jackm2983/mmwLab/README.md

# Advanced Microwave Lab
EE541  
Dr. Nayeri  
Spring 2026  

## Team Members
Jack Marshall  
Mark Negus  
Antoni Gonzalez  
Leo Joseph Alvelais  
Paul Obrecht  
William Robert Pfaff
