jackm2983/mmwLab/hpbw.png

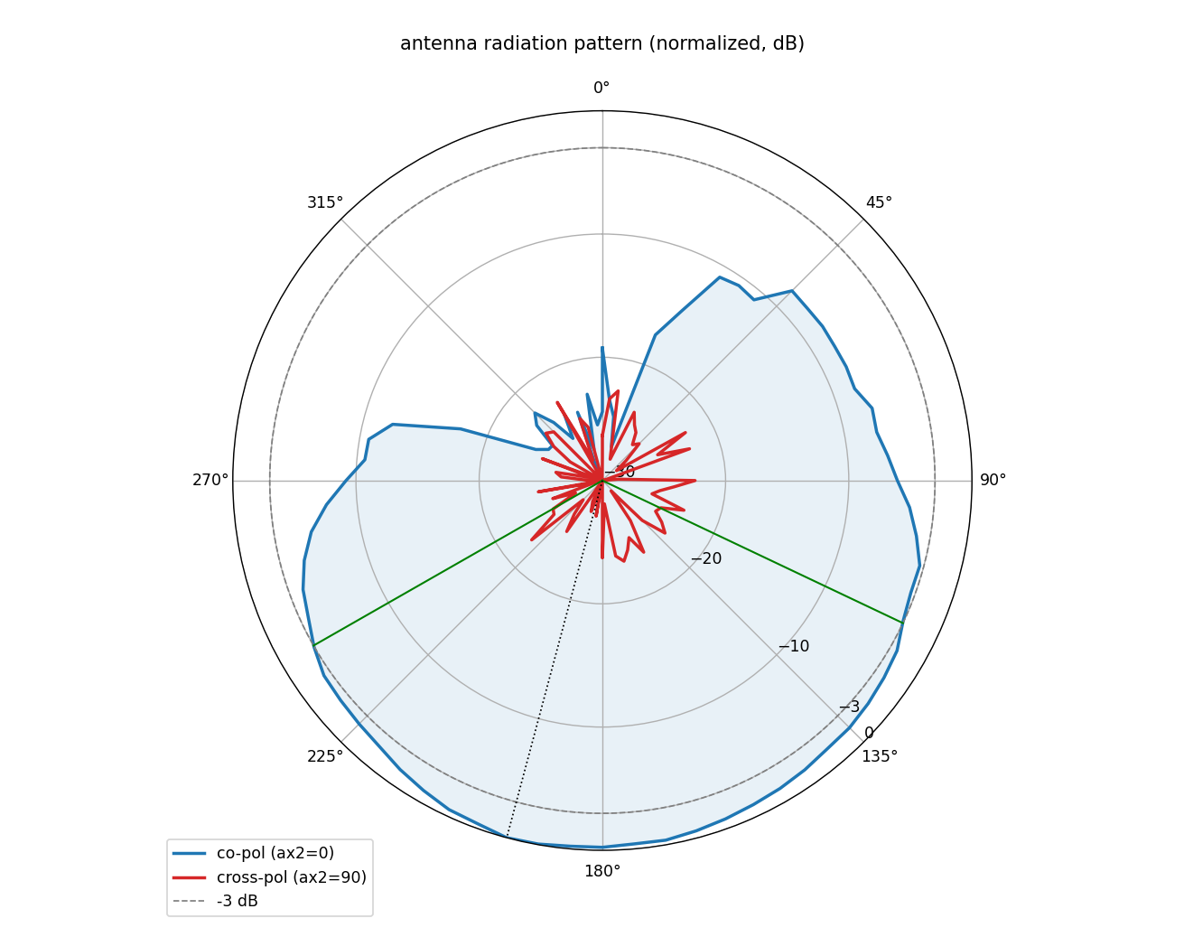
hpbw.png
