jackm2983/mmwLab/polar_sweep_001_ax2_1.png

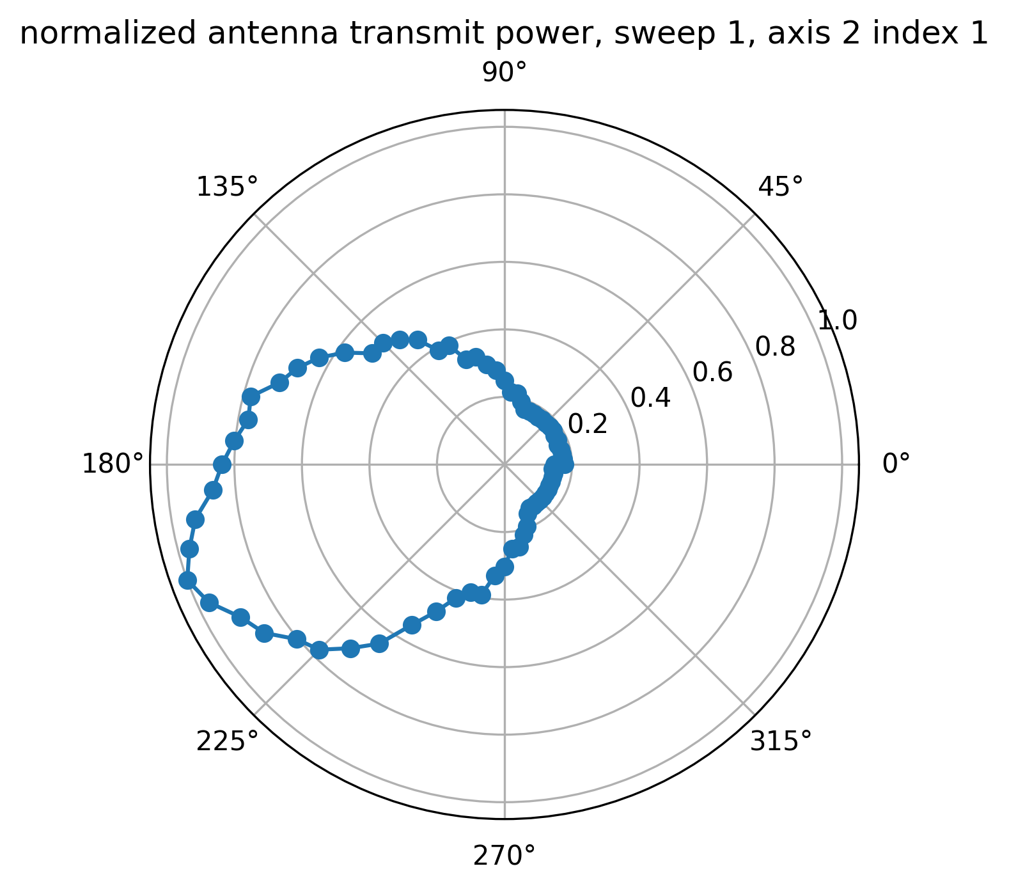
polar_sweep_001_ax2_1.png
