jackm2983/mmwLab/polarization_waterfall.png

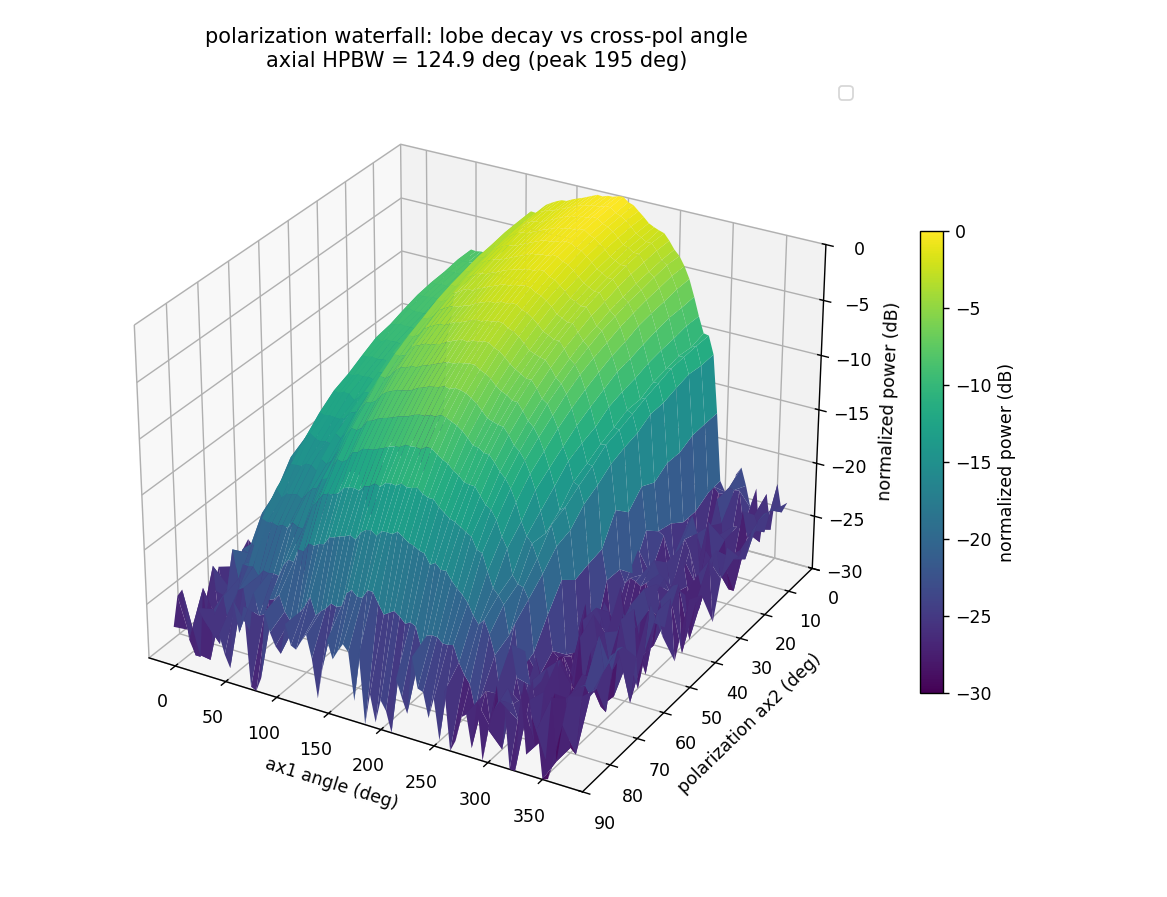
polarization_waterfall.png
