jackm2983/mmwLab/3Dmodels/rev3/new/tilt-pulley-mount2.STEP

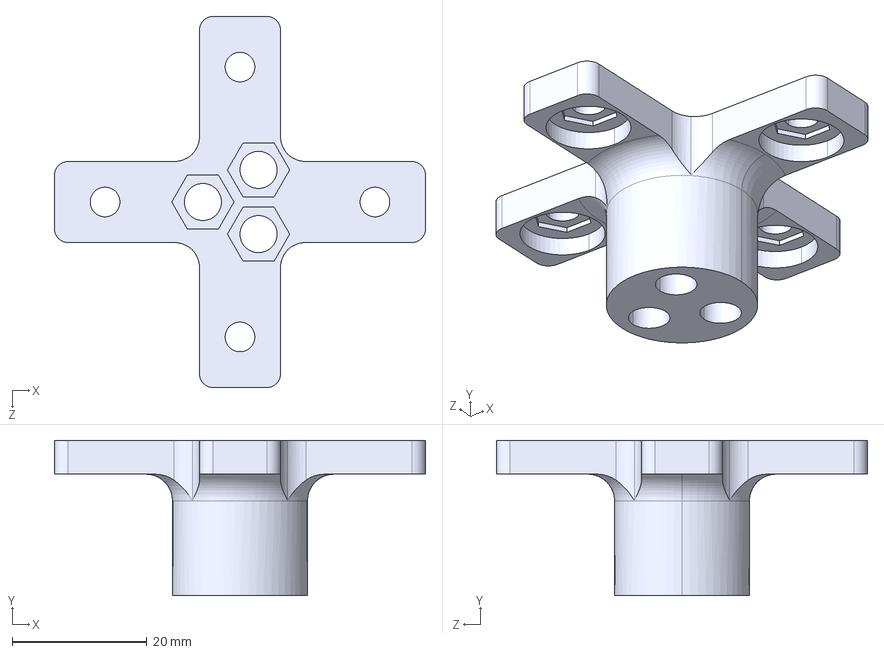
[picture p73: CAD file, 2026-05-03]
3Dmodels/rev3/new/tilt-pulley-mount2.STEP
55.0 x 23.0 x 55.0 mm
