jackm2983/mmwLab/3Dmodels/rev3/new2/tilt-pulley-mount3.step

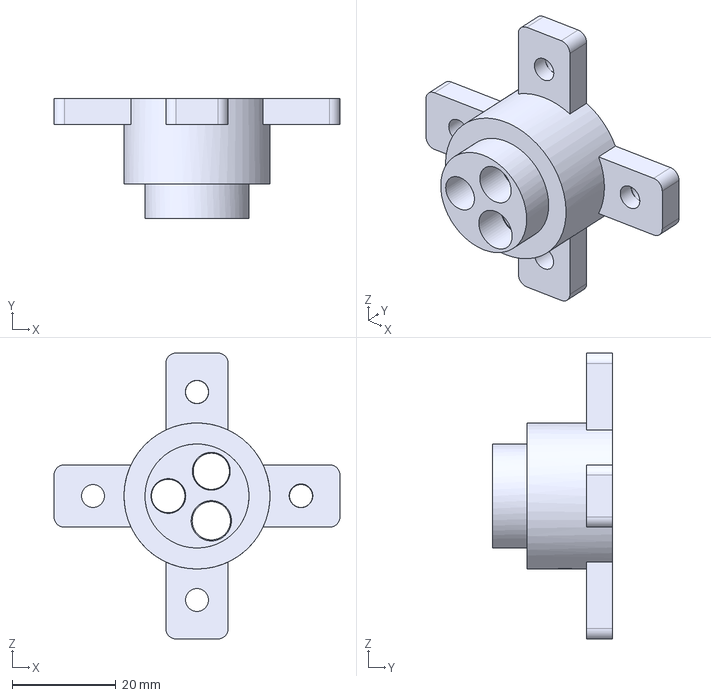
[picture p74: CAD file, 2026-05-07]
3Dmodels/rev3/new2/tilt-pulley-mount3.step
55.0 x 23.0 x 55.0 mm
