jackm2983/mmwLab/3Dmodels/rev3/tilt-arm-brace.step

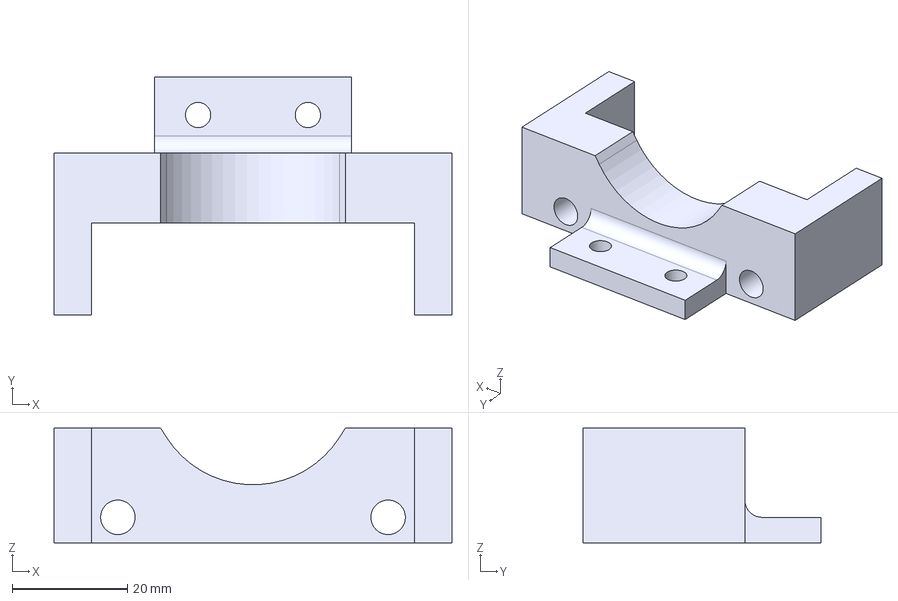
[picture p75: CAD file, 2026-05-03]
3Dmodels/rev3/tilt-arm-brace.step
69.2 x 41.4 x 20.0 mm
