jackm2983/mmwLab/3Dmodels/rev3/new/motor_driver_case.step

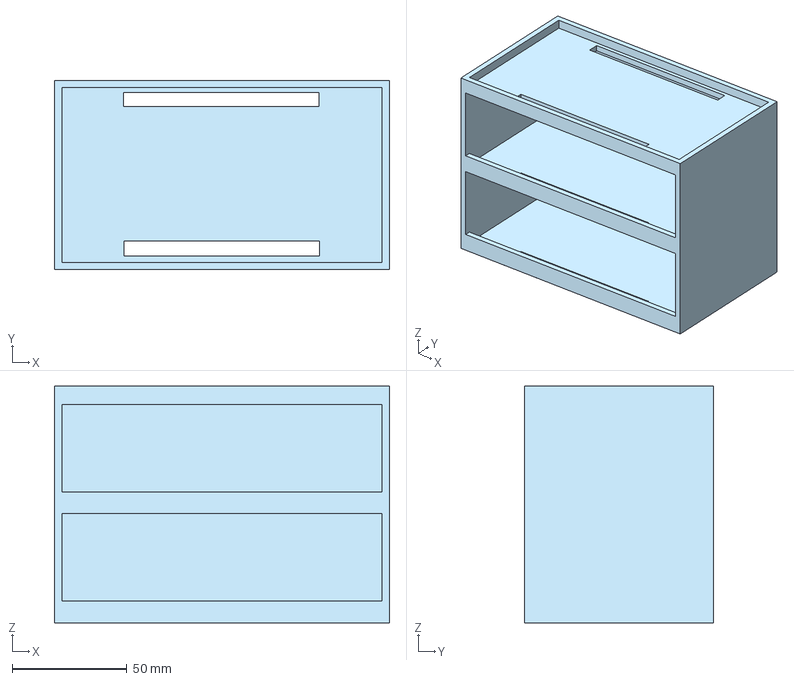
[picture p76: CAD file, 2026-05-03]
3Dmodels/rev3/new/motor_driver_case.step
146.1 x 82.5 x 103.2 mm
