jackm2983/mmwLab/3Dmodels/rev3/pan-pulley-114t-gt2-pulley-9mm-wide.step

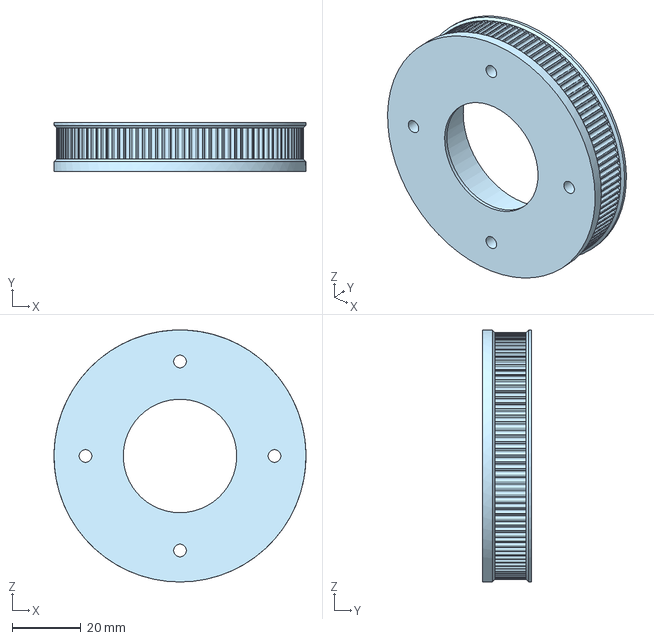
[picture p77: CAD file, 2026-05-03]
3Dmodels/rev3/pan-pulley-114t-gt2-pulley-9mm-wide.step
73.3 x 14.2 x 73.3 mm
