jackm2983/mmwLab/3Dmodels/rev3/new/base2.STEP

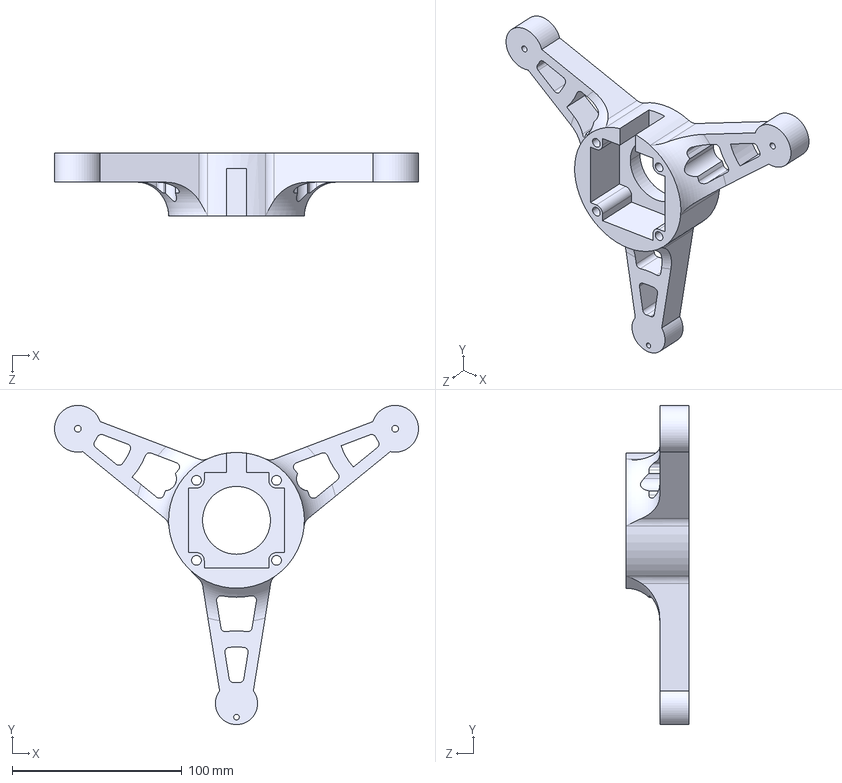
[picture p78: CAD file, 2026-05-03]
3Dmodels/rev3/new/base2.STEP
214.5 x 188.1 x 37.3 mm
