jackm2983/mmwLab/3Dmodels/rev3/tilt-pulley-98t-gt2-pulley-9mm-wide.step

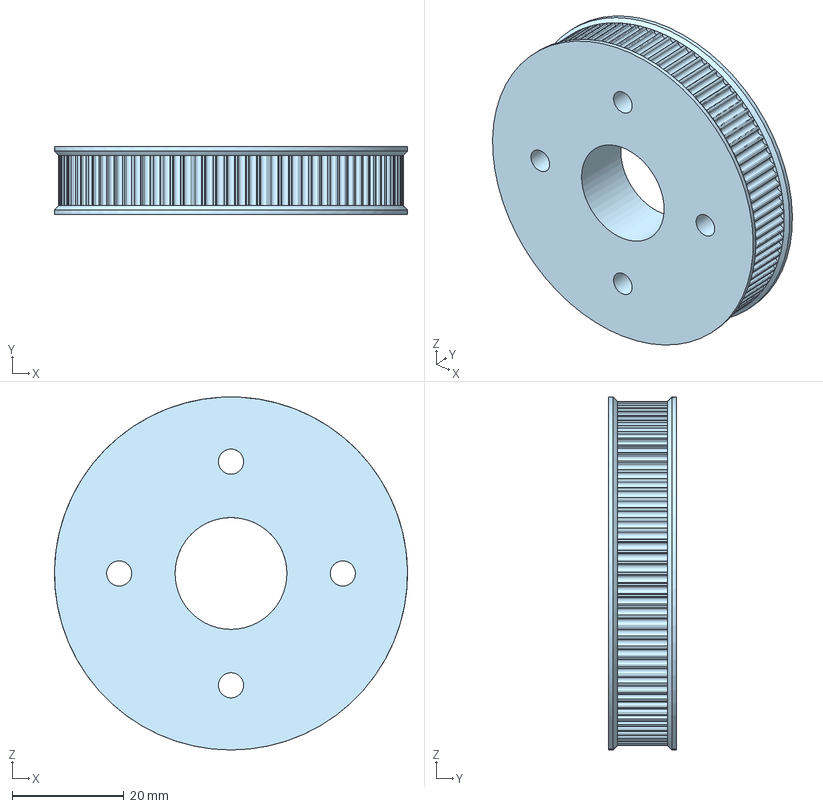
[picture p79: CAD file, 2026-05-03]
3Dmodels/rev3/tilt-pulley-98t-gt2-pulley-9mm-wide.step
63.1 x 12.2 x 63.1 mm
