jackm2983/mmwLab/3Dmodels/rev3/new/tilt-arm2.STEP

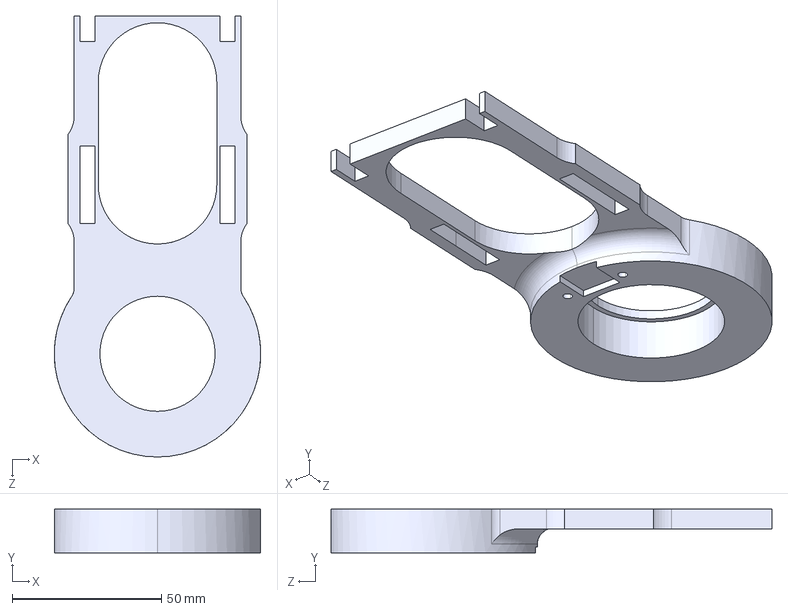
[picture p80: CAD file, 2026-05-03]
3Dmodels/rev3/new/tilt-arm2.STEP
69.2 x 14.6 x 147.9 mm
