jackm2983/mmwLab/3Dmodels/rev3/pan-endstop-mount.step

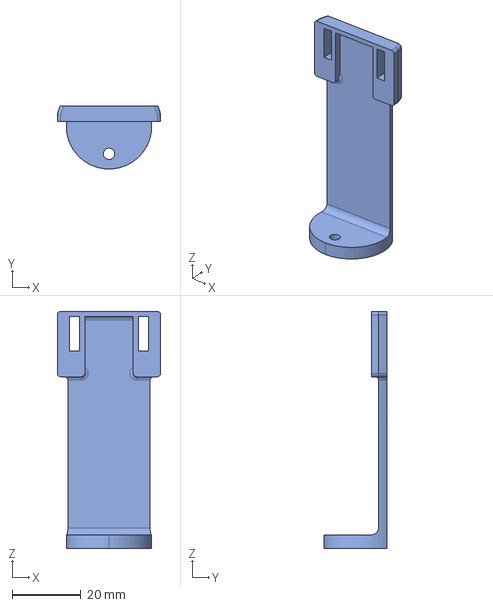
[picture p81: CAD file, 2026-05-03]
3Dmodels/rev3/pan-endstop-mount.step
30.1 x 18.4 x 69.0 mm
