jackm2983/mmwLab/3Dmodels/rev3/tilt-pulley-mount.step

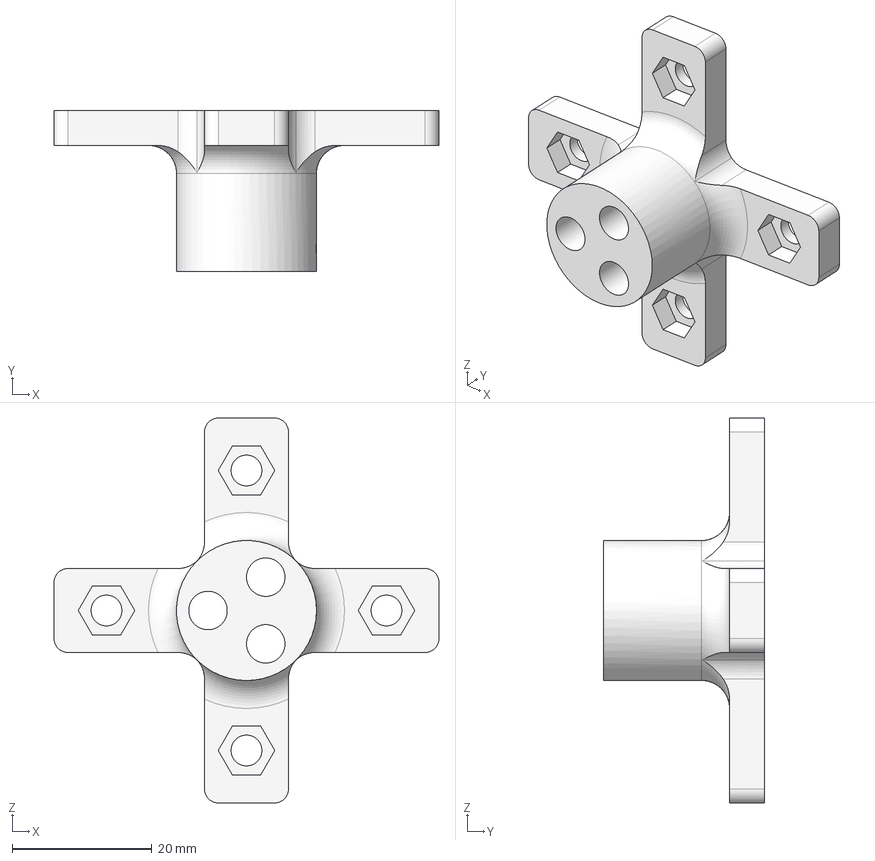
[picture p82: CAD file, 2026-05-03]
3Dmodels/rev3/tilt-pulley-mount.step
55.0 x 23.0 x 55.0 mm
