jackm2983/mmwLab/3Dmodels/rev3/tilt-endstop-triggers.step

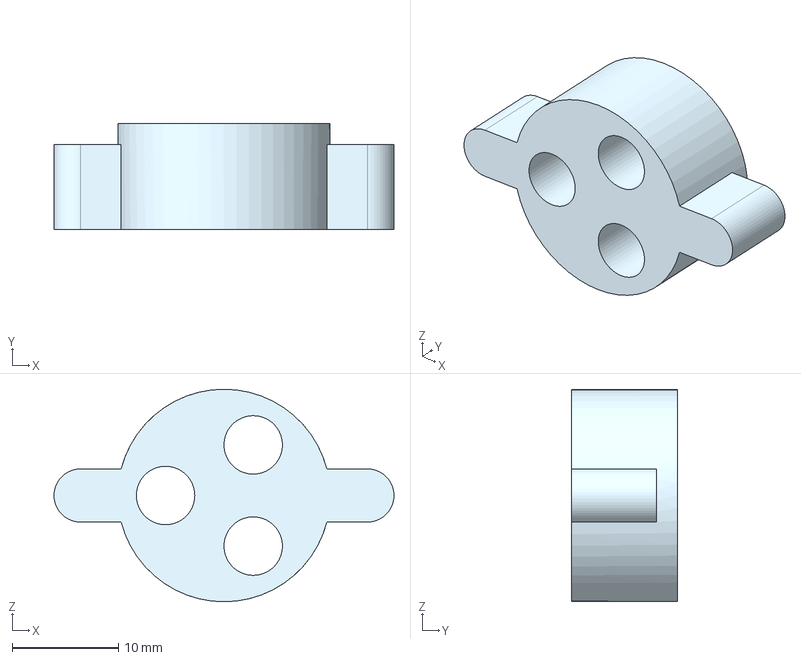
[picture p83: CAD file, 2026-05-03]
3Dmodels/rev3/tilt-endstop-triggers.step
32.0 x 10.0 x 20.0 mm
