jackm2983/mmwLab/3Dmodels/rev3/tilt-arm.step

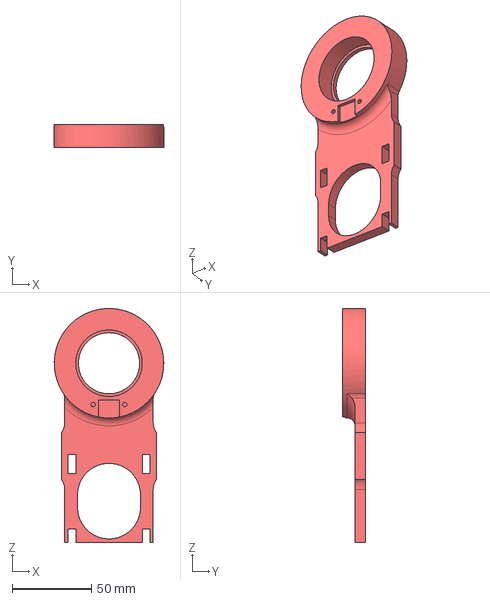
[picture p84: CAD file, 2026-05-03]
3Dmodels/rev3/tilt-arm.step
69.2 x 14.6 x 147.8 mm
