jackm2983/mmwLab/3Dmodels/rev3/pan-bearing-holder.step

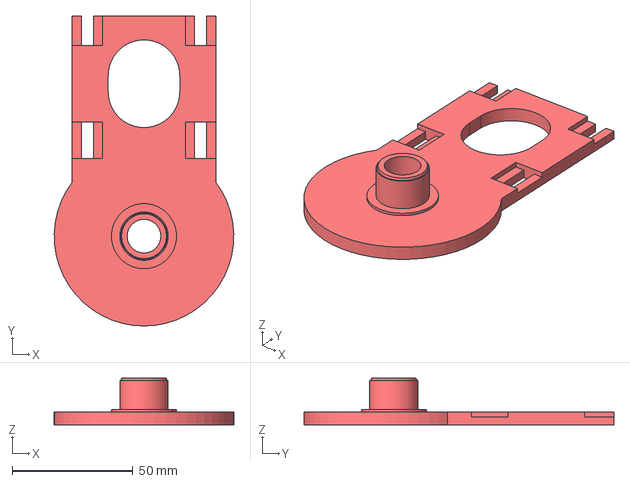
[picture p85: CAD file, 2026-05-03]
3Dmodels/rev3/pan-bearing-holder.step
74.5 x 128.6 x 19.3 mm
