jackm2983/mmwLab/3Dmodels/rev3/brace.step

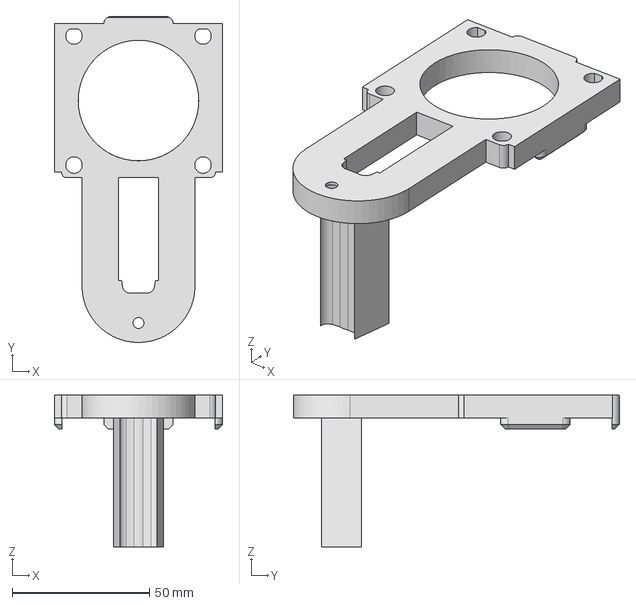
[picture p86: CAD file, 2026-05-03]
3Dmodels/rev3/brace.step
61.2 x 118.7 x 55.3 mm
