jackm2983/mmwLab/3Dmodels/rev3/tilt-motor-brace.step

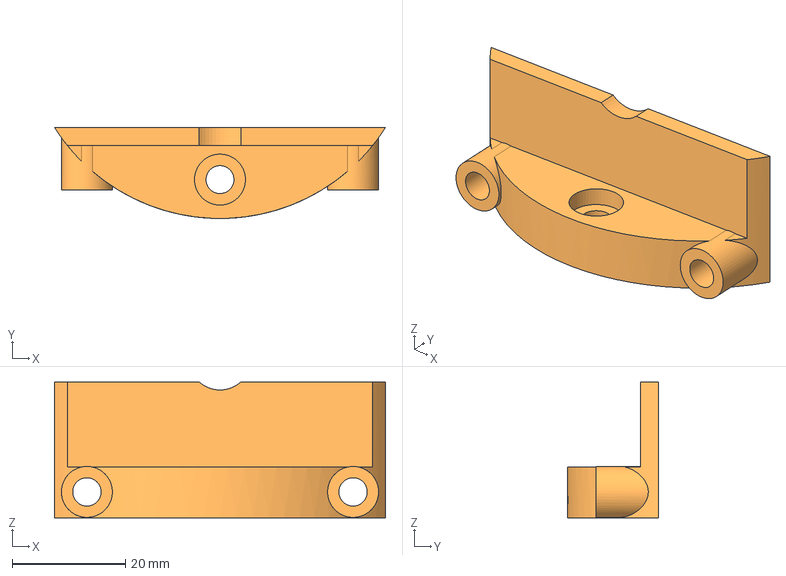
[picture p87: CAD file, 2026-05-03]
3Dmodels/rev3/tilt-motor-brace.step
58.4 x 16.1 x 24.0 mm
