jackm2983/mmwLab/3Dmodels/rev3/base.step

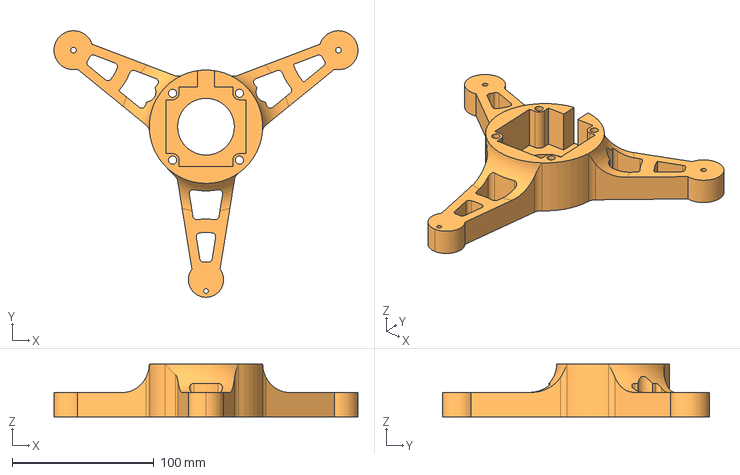
[picture p88: CAD file, 2026-05-03]
3Dmodels/rev3/base.step
214.5 x 188.1 x 37.3 mm
