jackm2983/mmwLab/3Dmodels/rev3/sony-rx100-iii-mount.step

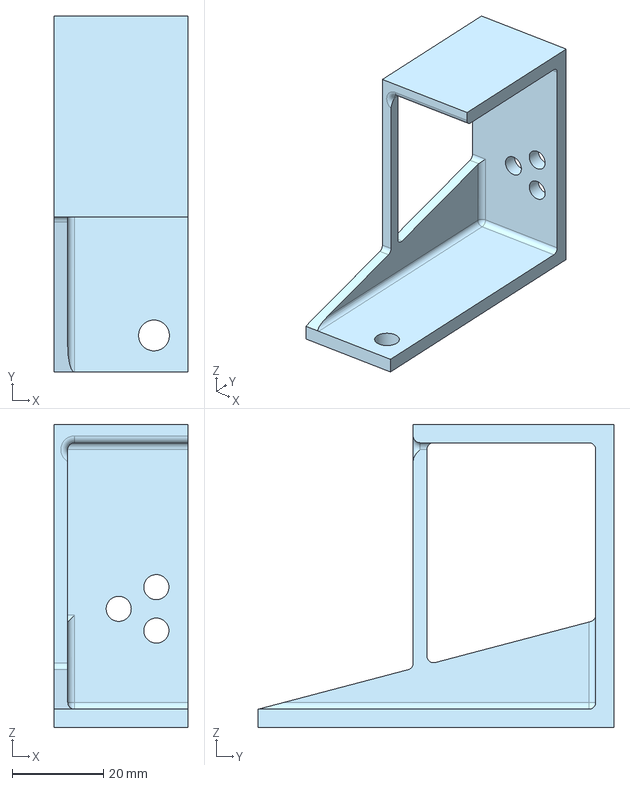
[picture p89: CAD file, 2026-05-03]
3Dmodels/rev3/sony-rx100-iii-mount.step
29.4 x 78.0 x 66.4 mm
