jackm2983/mmwLab/3Dmodels/rev3/pan-arm.step

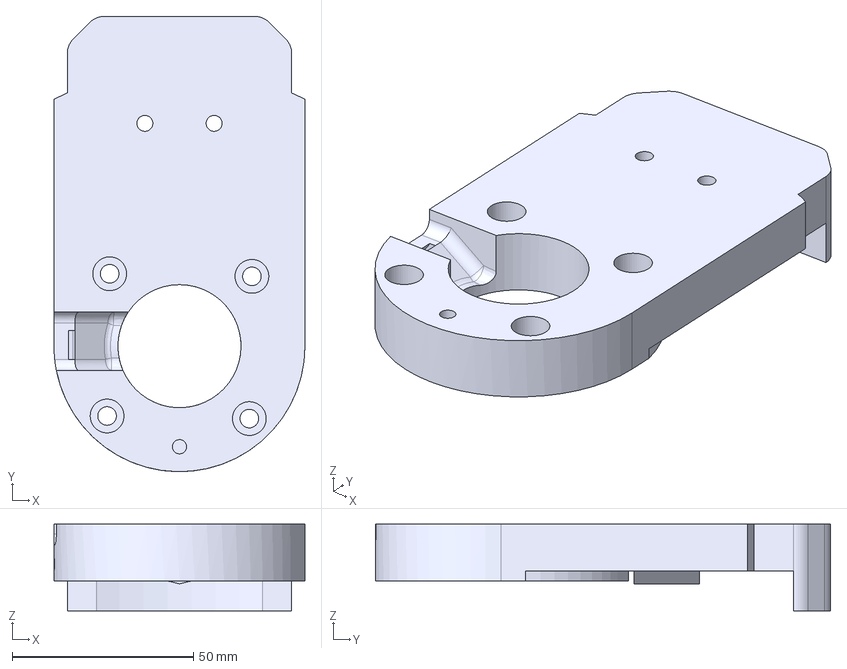
[picture p90: CAD file, 2026-05-03]
3Dmodels/rev3/pan-arm.step
69.2 x 125.6 x 24.0 mm
