jackm2983/mmwLab/(list of files, cad)

Other CAD files:
3Dmodels/rev3/brace.step.SLDPRT
3Dmodels/rev3/base.SLDPRT
3Dmodels/rev3/sony-rx100-iii-mount.SLDPRT
3Dmodels/rev3/tilt-arm.SLDPRT
3Dmodels/rev3/tilt-endstop-triggers.SLDPRT
3Dmodels/rev3/tilt-motor-brace.SLDPRT
3Dmodels/rev3/tilt-pulley-mount.SLDPRT
