jackm2983/mmwLab/STM32/mmwLab_stm32/polar_plots/uart_capture_plot.py

import csv
import math
import os
import queue
import threading
import time
from datetime import datetime

import matplotlib.pyplot as plt
import serial


PORT = "COM3"
BAUD = 9600

RAW_CSV_PATH = "capture_log_raw.csv"
NORMALIZED_CSV_PATH = "capture_log_normalized.csv"

# scripts are inside polar_plots, so save pngs in the current folder
PNG_DIR = "."

AX1_STEPS_PER_REV = 72


def cleanup_previous_capture():
    for path in (RAW_CSV_PATH, NORMALIZED_CSV_PATH):
        if os.path.exists(path):
            os.remove(path)
            print(f"deleted {path}")

    for filename in os.listdir(PNG_DIR):
        if filename.lower().endswith(".png"):
            png_path = os.path.join(PNG_DIR, filename)
            os.remove(png_path)
            print(f"deleted {png_path}")


def serial_reader(ser, line_queue, stop_event):
    while not stop_event.is_set():
        try:
            raw = ser.readline()

            if not raw:
                continue

            line = raw.decode("utf-8", errors="replace").strip()

            if line:
                print(line)
                line_queue.put(line)

        except serial.SerialException as e:
            print(f"serial error: {e}")
            stop_event.set()
            break


def serial_writer(ser, stop_event):
    import msvcrt

    while not stop_event.is_set():
        if msvcrt.kbhit():
            ch = msvcrt.getch()

            if ch in (b"\x00", b"\xe0"):
                msvcrt.getch()
                continue

            if ch == b"\x03":
                stop_event.set()
                break

            ser.write(ch)

        time.sleep(0.005)


def parse_cap_step_header(line):
    """Parse cap_step header line with new raw sampling format"""
    parts = line.split(",")

    if len(parts) != 6 or parts[0] != "cap_step":
        return None

    try:
        ax1_idx = int(parts[1])
        ax2_idx = int(parts[2])
        ax1_pos = int(parts[3])
        ax2_pos = int(parts[4])
        sample_count = int(parts[5])
    except ValueError:
        return None

    return {
        "ax1_idx": ax1_idx,
        "ax2_idx": ax2_idx,
        "ax1_pos": ax1_pos,
        "ax2_pos": ax2_pos,
        "sample_count": sample_count,
    }


def parse_cap_sample(line):
    """Parse individual cap_sample line with filtered I/Q values"""
    parts = line.split(",")

    if len(parts) != 3 or parts[0] != "cap_sample":
        return None

    try:
        i_filt = float(parts[1])
        q_filt = float(parts[2])
    except ValueError:
        return None

    # Compute magnitude (power) for this sample
    magnitude = math.sqrt(i_filt * i_filt + q_filt * q_filt)

    return {
        "i": i_filt,
        "q": q_filt,
        "magnitude": magnitude,
    }


def compute_step_power(samples):
    """
    Compute power for a measurement step from a list of samples.
    Uses the peak-to-peak amplitude of the signal over the measurement window.
    """
    if not samples:
        return 0.0

    # Find min and max magnitude across all samples
    magnitudes = [s["magnitude"] for s in samples]
    min_mag = min(magnitudes)
    max_mag = max(magnitudes)

    # Power is derived from peak-to-peak amplitude
    # For a sinusoid with amplitude A, peak-to-peak is 2A, so A = (max-min)/2
    # Power ~ A^2 ~ ((max-min)/2)^2
    peak_to_peak = max_mag - min_mag

    # Return RMS-like estimate: (peak_to_peak / 2)^2 / 2
    # Or simpler: just use max magnitude as power estimate
    return max_mag


def parse_cap_line_old(line):
    """Parse old single-value format (kept for compatibility if needed)"""
    parts = line.split(",")

    if len(parts) != 7 or parts[0] != "cap":
        return None

    try:
        ax1_idx = int(parts[1])
        ax2_idx = int(parts[2])
        ax1_pos = int(parts[3])
        ax2_pos = int(parts[4])
        i_val = int(parts[5])
        q_val = int(parts[6])
    except ValueError:
        return None

    power = math.sqrt(i_val * i_val + q_val * q_val)

    return {
        "timestamp": datetime.now().isoformat(timespec="milliseconds"),
        "ax1_idx": ax1_idx,
        "ax2_idx": ax2_idx,
        "ax1_pos": ax1_pos,
        "ax2_pos": ax2_pos,
        "i": i_val,
        "q": q_val,
        "power": power,
    }


def theta_from_ax1_idx(ax1_idx):
    return math.radians((ax1_idx * 360.0) / AX1_STEPS_PER_REV)


def save_sweep_png(rows, sweep_id, ax2_idx, path_dir=PNG_DIR):
    sweep_rows = [
        r for r in rows
        if r["sweep_id"] == sweep_id
    ]

    if not sweep_rows:
        return

    sweep_max_power = max(r["power"] for r in sweep_rows)

    theta = [
        theta_from_ax1_idx(r["ax1_idx"])
        for r in sweep_rows
    ]

    if sweep_max_power > 0:
        radius = [
            r["power"] / sweep_max_power
            for r in sweep_rows
        ]
    else:
        radius = [0.0 for _ in sweep_rows]

    os.makedirs(path_dir, exist_ok=True)

    png_path = os.path.join(
        path_dir,
        f"polar_sweep_{sweep_id:03d}_ax2_{ax2_idx}.png",
    )

    save_fig = plt.figure()
    save_ax = save_fig.add_subplot(111, projection="polar")

    save_ax.plot(theta, radius, marker="o")
    save_ax.set_title(
        f"normalized antenna transmit power, sweep {sweep_id}, axis 2 index {ax2_idx}"
    )
    save_ax.set_ylim(0, 1.05)
    save_ax.grid(True)

    save_fig.savefig(png_path, dpi=300, bbox_inches="tight")
    plt.close(save_fig)

    print(f"polar png written to {png_path}")


def write_normalized_csv(rows, path):
    if not rows:
        return

    sweep_max = {}

    for row in rows:
        sweep_id = row["sweep_id"]
        sweep_max[sweep_id] = max(sweep_max.get(sweep_id, 0.0), row["power"])

    normalized_rows = []

    for row in rows:
        out = row.copy()
        max_power = sweep_max[row["sweep_id"]]

        if max_power > 0:
            out["power_norm_sweep"] = out["power"] / max_power

            if out["power_norm_sweep"] > 0:
                out["power_db_norm"] = 20.0 * math.log10(out["power_norm_sweep"])
            else:
                out["power_db_norm"] = None
        else:
            out["power_norm_sweep"] = 0.0
            out["power_db_norm"] = None

        normalized_rows.append(out)

    fieldnames = [
        "timestamp",
        "sweep_id",
        "ax1_idx",
        "ax2_idx",
        "ax1_pos",
        "ax2_pos",
        "power",
        "power_norm_sweep",
        "power_db_norm",
    ]

    with open(path, "w", newline="") as f:
        writer = csv.DictWriter(f, fieldnames=fieldnames)
        writer.writeheader()
        writer.writerows(normalized_rows)


def main():
    cleanup_previous_capture()

    line_queue = queue.Queue()
    stop_event = threading.Event()

    ser = serial.Serial(PORT, BAUD, timeout=0.1)

    reader = threading.Thread(
        target=serial_reader,
        args=(ser, line_queue, stop_event),
        daemon=True,
    )

    writer = threading.Thread(
        target=serial_writer,
        args=(ser, stop_event),
        daemon=True,
    )

    reader.start()
    writer.start()

    rows = []

    sweep_id = -1
    last_ax2_idx = None
    current_sweep_id = None
    current_ax2_idx = None
    saved_sweep_ids = set()

    raw_fieldnames = [
        "timestamp",
        "sweep_id",
        "ax1_idx",
        "ax2_idx",
        "ax1_pos",
        "ax2_pos",
        "power",
        "sample_count",
    ]

    raw_csv_file = open(RAW_CSV_PATH, "w", newline="")
    raw_writer = csv.DictWriter(raw_csv_file, fieldnames=raw_fieldnames)
    raw_writer.writeheader()

    plt.ion()

    fig = plt.figure()
    ax = fig.add_subplot(111, projection="polar")

    line_plot, = ax.plot([], [], marker="o")

    ax.set_title("normalized antenna transmit power")
    ax.set_ylim(0, 1.05)
    ax.grid(True)

    # State for buffering samples during streaming
    current_step = None
    buffered_samples = []

    try:
        while not stop_event.is_set():
            updated = False

            while not line_queue.empty():
                line = line_queue.get()

                # Parse cap_step header
                step_header = parse_cap_step_header(line)
                if step_header is not None:
                    # If we have buffered samples from previous step, process them
                    if current_step is not None and buffered_samples:
                        # Compute power from buffered samples
                        power = compute_step_power(buffered_samples)

                        row = {
                            "timestamp": datetime.now().isoformat(timespec="milliseconds"),
                            "ax1_idx": current_step["ax1_idx"],
                            "ax2_idx": current_step["ax2_idx"],
                            "ax1_pos": current_step["ax1_pos"],
                            "ax2_pos": current_step["ax2_pos"],
                            "power": power,
                            "sample_count": len(buffered_samples),
                        }

                        # Check if this is a new sweep (new ax2_idx)
                        if row["ax2_idx"] != last_ax2_idx:
                            if (
                                current_sweep_id is not None
                                and current_sweep_id not in saved_sweep_ids
                            ):
                                save_sweep_png(rows, current_sweep_id, current_ax2_idx)
                                saved_sweep_ids.add(current_sweep_id)

                            sweep_id += 1
                            last_ax2_idx = row["ax2_idx"]
                            print(f"new sweep {sweep_id}, axis 2 index {row['ax2_idx']}")

                        row["sweep_id"] = sweep_id

                        rows.append(row)
                        raw_writer.writerow(row)
                        raw_csv_file.flush()

                        current_sweep_id = sweep_id
                        current_ax2_idx = row["ax2_idx"]
                        updated = True

                    # Start buffering for new step
                    current_step = step_header
                    buffered_samples = []
                    continue

                # Parse cap_sample line
                sample = parse_cap_sample(line)
                if sample is not None:
                    buffered_samples.append(sample)
                    continue

                # Handle end of capture
                if line == "cap_end":
                    # Process last buffered samples
                    if current_step is not None and buffered_samples:
                        power = compute_step_power(buffered_samples)

                        row = {
                            "timestamp": datetime.now().isoformat(timespec="milliseconds"),
                            "ax1_idx": current_step["ax1_idx"],
                            "ax2_idx": current_step["ax2_idx"],
                            "ax1_pos": current_step["ax1_pos"],
                            "ax2_pos": current_step["ax2_pos"],
                            "power": power,
                            "sample_count": len(buffered_samples),
                        }

                        if row["ax2_idx"] != last_ax2_idx:
                            if (
                                current_sweep_id is not None
                                and current_sweep_id not in saved_sweep_ids
                            ):
                                save_sweep_png(rows, current_sweep_id, current_ax2_idx)
                                saved_sweep_ids.add(current_sweep_id)

                            sweep_id += 1
                            last_ax2_idx = row["ax2_idx"]

                        row["sweep_id"] = sweep_id

                        rows.append(row)
                        raw_writer.writerow(row)
                        raw_csv_file.flush()

                        current_sweep_id = sweep_id
                        current_ax2_idx = row["ax2_idx"]
                        updated = True

                    print("Capture complete")
                    stop_event.set()
                    continue

            if updated and current_sweep_id is not None:
                plot_rows = [
                    r for r in rows
                    if r["sweep_id"] == current_sweep_id
                ]

                if plot_rows:
                    sweep_max_power = max(r["power"] for r in plot_rows)

                    theta = [
                        theta_from_ax1_idx(r["ax1_idx"])
                        for r in plot_rows
                    ]

                    if sweep_max_power > 0:
                        radius = [
                            r["power"] / sweep_max_power
                            for r in plot_rows
                        ]
                    else:
                        radius = [0.0 for _ in plot_rows]

                    line_plot.set_data(theta, radius)

                    ax.set_title(
                        f"normalized antenna transmit power, "
                        f"sweep {current_sweep_id}, axis 2 index {current_ax2_idx}"
                    )

                    fig.canvas.draw()
                    fig.canvas.flush_events()

            time.sleep(0.02)

    except KeyboardInterrupt:
        pass

    finally:
        stop_event.set()

        try:
            ser.close()
        except serial.SerialException:
            pass

        raw_csv_file.close()

        if (
            current_sweep_id is not None
            and current_sweep_id not in saved_sweep_ids
        ):
            save_sweep_png(rows, current_sweep_id, current_ax2_idx)
            saved_sweep_ids.add(current_sweep_id)

        write_normalized_csv(rows, NORMALIZED_CSV_PATH)

        print(f"raw csv written to {RAW_CSV_PATH}")
        print(f"normalized csv written to {NORMALIZED_CSV_PATH}")
        print("polar png files written to current folder")

        plt.ioff()
        plt.show()


if __name__ == "__main__":
    main()
