jackm2983/mmwLab/STM32/mmwLab_stm32/src/app/app_mode_cap.c

/**
  ******************************************************************************
  * @file           : app_mode_cap.c
  * @brief          : 2-axis sweep capture (motor1 inner, motor2 outer)
  ******************************************************************************
*/

#include "main.h"
#include "cfg_sys.h"
#include "drv_cmd.h"
#include "drv_store.h"
#include "mot_ctrl.h"
#include "mot_axis.h"
#include "bsp_adc.h"
#include "bsp_uart.h"
#include <stdio.h>

#define CAP_DEBUG               0

#define CAP_ROTATION_SPEED      4000
#define CAP_AXIS1_SUBDIVISIONS  72
#define CAP_AXIS2_SUBDIVISIONS  18
#define CAP_SETTLE_MS           200

#define AXIS1_HOME_SEEK_STEPS   10000

typedef enum {
    CAP_INIT,
    CAP_HOME_AX2,
    CAP_HOME_AX1,
    CAP_WAIT_AX1,
    CAP_SETTLE,
    CAP_SAMPLE_START,
    CAP_SAMPLE_WAIT,
    CAP_SAMPLE_FILTER,
    CAP_SAMPLE_SEND,
    CAP_NEXT,
    CAP_DONE
} CapState_t;

static CapState_t cap_state = CAP_INIT;
static uint32_t cap_settle_start = 0;

static int32_t cap_ax1_idx = 0;
static int32_t cap_ax2_idx = 0;

static int32_t cap_ax1_start = 0;
static int32_t cap_ax1_end = 0;
static int32_t cap_ax2_start = 0;
static int32_t cap_ax2_end = 0;

static uint32_t cap_samples_done = 0;
static uint32_t cap_samples_total = 0;

/* Sampling state variables */
static uint16_t cap_sample_count = 0;
static float *cap_samples_i_filt = NULL;
static float *cap_samples_q_filt = NULL;
static uint16_t cap_sample_idx = 0;  /* Index for sending samples */

static void send_int(int32_t v)
{
    if (v < 0) { bsp_uart_send_char('-'); v = -v; }
    char buf[12];
    int i = 0;
    if (v == 0) { buf[i++] = '0'; }
    else {
        char tmp[12];
        int j = 0;
        while (v > 0) { tmp[j++] = '0' + (v % 10); v /= 10; }
        while (j > 0) { buf[i++] = tmp[--j]; }
    }
    buf[i] = 0;
    bsp_uart_send_string(buf);
}

static void send_float(float v)
{
    /* Send float with 6 decimal places using integer arithmetic */
    int32_t int_part = (int32_t)v;
    int32_t frac_part = (int32_t)((v - int_part) * 1000000.0f);
    
    if (v < 0 && int_part == 0) {
        bsp_uart_send_char('-');
    }
    
    send_int(int_part);
    bsp_uart_send_char('.');
    
    /* Send fractional part with leading zeros */
    if (frac_part < 0) frac_part = -frac_part;
    
    char frac_buf[10];
    snprintf(frac_buf, sizeof(frac_buf), "%06ld", (long)frac_part);
    bsp_uart_send_string(frac_buf);
}

static int32_t interp_pos(int32_t start, int32_t end, int32_t idx, int32_t total)
{
    if (total == 0) return start;
    return start + ((end - start) * idx) / total;
}

static void cap_emit_sample(int32_t ax1_pos, int32_t ax2_pos, uint16_t i_val, uint16_t q_val)
{
    bsp_uart_send_string("cap,");
    send_int(cap_ax1_idx);
    bsp_uart_send_char(',');
    send_int(cap_ax2_idx);
    bsp_uart_send_char(',');
    send_int(ax1_pos);
    bsp_uart_send_char(',');
    send_int(ax2_pos);
    bsp_uart_send_char(',');
    send_int(i_val);
    bsp_uart_send_char(',');
    send_int(q_val);
    bsp_uart_send_string("\r\n");
}

static void cap_emit_sample_header(int32_t ax1_pos, int32_t ax2_pos, uint16_t sample_count)
{
    bsp_uart_send_string("cap_step,");
    send_int(cap_ax1_idx);
    bsp_uart_send_char(',');
    send_int(cap_ax2_idx);
    bsp_uart_send_char(',');
    send_int(ax1_pos);
    bsp_uart_send_char(',');
    send_int(ax2_pos);
    bsp_uart_send_char(',');
    send_int(sample_count);
    bsp_uart_send_string("\r\n");
}

static void cap_emit_sample_data(float i_filt, float q_filt)
{
    bsp_uart_send_string("cap_sample,");
    send_float(i_filt);
    bsp_uart_send_char(',');
    send_float(q_filt);
    bsp_uart_send_string("\r\n");
}

static void cap_emit_progress(void)
{
    bsp_uart_send_string("CAP: ");
    send_int(cap_samples_done);
    bsp_uart_send_char('/');
    send_int(cap_samples_total);
    bsp_uart_send_string(" ax1_idx=");
    send_int(cap_ax1_idx);
    bsp_uart_send_string(" ax2_idx=");
    send_int(cap_ax2_idx);
    bsp_uart_send_string("\r\n");
}

void app_mode_cap_update(void)
{
    switch (cap_state)
    {
        case CAP_INIT: {
            drv_cmd_send_status("CAP: starting 2-axis sweep");

            int32_t a1min, a1max, a2min, a2max;
            drv_store_get_axis1_bounds(&a1min, &a1max);
            drv_store_get_axis2_bounds(&a2min, &a2max);

            cap_ax1_start = a1max;
            cap_ax1_end = a1min;
            cap_ax2_start = a2max;
            cap_ax2_end = a2min;

#if CAP_DEBUG
            bsp_uart_send_string("DBG cap: sweep ax1 ");
            send_int(cap_ax1_start);
            bsp_uart_send_string(" -> ");
            send_int(cap_ax1_end);
            bsp_uart_send_string("\r\n");
            bsp_uart_send_string("DBG cap: sweep ax2 ");
            send_int(cap_ax2_start);
            bsp_uart_send_string(" -> ");
            send_int(cap_ax2_end);
            bsp_uart_send_string("\r\n");
#endif

            cap_ax1_idx = 0;
            cap_ax2_idx = 0;
            cap_samples_done = 0;
            cap_samples_total = (CAP_AXIS1_SUBDIVISIONS + 1) *
                                (CAP_AXIS2_SUBDIVISIONS + 1);

            int32_t ax2_target = interp_pos(cap_ax2_start, cap_ax2_end,
                                            cap_ax2_idx, CAP_AXIS2_SUBDIVISIONS);

            mot_ctrl_move_axis2_abs(ax2_target, CAP_ROTATION_SPEED);
            cap_state = CAP_HOME_AX2;
            break;
        }

        case CAP_HOME_AX2:
            if (!mot_axis2_is_moving()) {
                if (cap_ax1_idx == 0) {
                    mot_ctrl_move_axis1_abs(cap_ax1_start + AXIS1_HOME_SEEK_STEPS,
                                            CAP_ROTATION_SPEED);
                    cap_state = CAP_HOME_AX1;
                } else {
                    int32_t ax1_target = interp_pos(cap_ax1_start, cap_ax1_end,
                                                    cap_ax1_idx,
                                                    CAP_AXIS1_SUBDIVISIONS);
                    mot_ctrl_move_axis1_abs(ax1_target, CAP_ROTATION_SPEED);
                    cap_state = CAP_WAIT_AX1;
                }
            }
            break;

        case CAP_HOME_AX1:
            if (mot_axis1_limit_triggered()) {
                mot_ctrl_stop_axis1();
                mot_axis1_set_position(cap_ax1_start);
                mot_axis1_set_homed();
                cap_settle_start = HAL_GetTick();
                cap_state = CAP_SETTLE;
            }
            break;

        case CAP_WAIT_AX1:
            if (!mot_axis1_is_moving()) {
                cap_settle_start = HAL_GetTick();
                cap_state = CAP_SETTLE;
            }
            break;

        case CAP_SETTLE:
            if ((HAL_GetTick() - cap_settle_start) >= CAP_SETTLE_MS) {
                cap_state = CAP_SAMPLE_START;
            }
            break;

        case CAP_SAMPLE_START:
            /* Initialize sampling */
            bsp_adc_sampling_reset();
            bsp_adc_start_continuous();
            cap_state = CAP_SAMPLE_WAIT;
            break;

        case CAP_SAMPLE_WAIT:
            /* Wait for sampling to complete */
            if (bsp_adc_sampling_complete()) {
                cap_state = CAP_SAMPLE_FILTER;
            }
            break;

        case CAP_SAMPLE_FILTER:
            /* Apply bandpass filter to captured samples */
            bsp_adc_filter_samples();
            cap_state = CAP_SAMPLE_SEND;
            cap_sample_idx = 0;
            break;

        case CAP_SAMPLE_SEND: {
            /* Get filtered samples */
            bsp_adc_get_filtered_samples(&cap_samples_i_filt, &cap_samples_q_filt, &cap_sample_count);

            /* Send header on first call to this state */
            if (cap_sample_idx == 0) {
                int32_t ax1_pos = mot_axis1_get_position();
                int32_t ax2_pos = mot_axis2_get_position();
                cap_emit_sample_header(ax1_pos, ax2_pos, cap_sample_count);
            }

            /* Send samples one at a time to avoid buffer overflow */
            if (cap_sample_idx < cap_sample_count) {
                cap_emit_sample_data(cap_samples_i_filt[cap_sample_idx], 
                                     cap_samples_q_filt[cap_sample_idx]);
                cap_sample_idx++;
            } else {
                /* All samples sent, move to next step */
                cap_samples_done++;

#if CAP_DEBUG
                if ((cap_samples_done % 10) == 0) {
                    cap_emit_progress();
                }
#endif

                cap_state = CAP_NEXT;
            }
            break;
        }

        case CAP_NEXT:
            cap_ax1_idx++;

            if (cap_ax1_idx <= CAP_AXIS1_SUBDIVISIONS) {
                int32_t ax1_target = interp_pos(cap_ax1_start, cap_ax1_end,
                                                cap_ax1_idx,
                                                CAP_AXIS1_SUBDIVISIONS);
                mot_ctrl_move_axis1_abs(ax1_target, CAP_ROTATION_SPEED);
                cap_state = CAP_WAIT_AX1;
            } else {
                cap_ax2_idx++;

                if (cap_ax2_idx <= CAP_AXIS2_SUBDIVISIONS) {
                    cap_ax1_idx = 0;

                    int32_t ax2_target = interp_pos(cap_ax2_start, cap_ax2_end,
                                                    cap_ax2_idx,
                                                    CAP_AXIS2_SUBDIVISIONS);
                    mot_ctrl_move_axis2_abs(ax2_target, CAP_ROTATION_SPEED);
                    cap_state = CAP_HOME_AX2;
                } else {
                    bsp_uart_send_string("cap_end\r\n");
                    drv_cmd_send_status("CAP: sweep complete");
                    cap_state = CAP_DONE;
                }
            }
            break;

        case CAP_DONE:
            break;

        default:
            cap_state = CAP_DONE;
            break;
    }
}

void app_mode_cap_reset(void)
{
    mot_ctrl_stop_all();
    cap_state = CAP_INIT;
    cap_ax1_idx = 0;
    cap_ax2_idx = 0;
    cap_samples_done = 0;
    cap_samples_total = 0;
    cap_settle_start = 0;
}
