jackm2983/mmwLab/(commit log)

2026-05-03 added some missing includes
    [app_state.c, drv_cmd.c]
2026-05-07 uart works in stmcube. updated ini file. still doesnt work in vscode.
2026-05-07 rev3 3d models
    [base.SLDPRT, base.step, base2.STEP, brace.step, brace.step.SLDPRT, motor_driver_case.step, pan-arm.step, pan-bearing-holder.step]
2026-05-13 fixed a motor rotation bug
    [app_mode_cap.c]
2026-05-19 capture, calibrate, and limit switch functionality
2026-05-20 fixed issues with position sensor
    [app_mode_cal.c, app_mode_cap.c, app_mode_jog.c, mot_axis.c, mot_ctrl.c]
2026-05-20 csv logging and I capture
    [capture_log.csv]
2026-05-20 removed the csv
    [capture_log.csv]
2026-05-21 fixed the plotting logic
    [uart_capture_plot.py]
2026-05-27 update gitignore
    [capture_log.csv]
2026-05-28 dont need the csv
    [capture_log.csv]
2026-05-28 removed random trace
2026-06-05 I havent tested this on hardware but it is a better method. send all the raw samples, after a little digital bandpass filtering, to pc and let the pc do the calculations.
